Dirt-Bag-Lab-Supplies/SimpleBuck/README.md

# SimpleBuck
Simple buck-converter with selectable output voltage and current.
