Dirt-Bag-Lab-Supplies/SimpleBuck/pcb/lm2596_breakout/bom/lm2596_breakout_bom.ods

null | Sourced | Placed | References | Value | Footprint | description | mfg | mfg_pn | place | vendor | vendor_pn | Quantity
1 |  |  | C1 | RUBYCON_100ZLH100MEFC10X20 | CP_Radial_D10.0mm_P5.00mm | CAP ALUM 100UF 20% 100V RADIAL | Rubycon | 100ZLH100MEFC10X20 | YES | Digikey | 1189-1887-ND | 1
2 |  |  | C2 | PANASONIC_EEU-FC1H221B | CP_Radial_D10.0mm_P5.00mm | CAP ALUM 220UF 20% 50V RADIAL | Panasonic Electronic Components | EEU-FC1H221B | YES | Digikey | P19654CT-ND | 1
3 |  |  | R1 | STACKPOLE_CSRT2512FT50L0-UP | R_2512 | RES, CS, 2512, 0.05 OHM, 1%, 3.5W | Stackpole Electronics | CSRT2512FT50L0-UP | YES | Digikey | 738-CSRT2512FT50L0-UPTR-ND | 1
4 |  |  | R2 | VISHAYDALE_CRCW06031K20FKEAC | R_0603 | RES 1.2K OHM 1% 1/10W 0603 | Vishay Dale | CRCW06031K20FKEAC | YES | Digikey | 541-5225-2-ND | 1
5 |  |  | L1 | BOURNS_SRR1260A-330M | L_12x12mm_h8mm |  | Bourns Inc | SRR1260A-330M | YES | Digikey | SRR1260A-330MCT-ND | 1
6 |  |  | D1 | VISHAY_SSA34HE3_A_I | D_SMA |  | Vishay General Semiconductor | SSA34HE3_A/I | yes | Digikey | SSA34HE3_A/IGITR-ND | 1
7 |  |  | U1 | NATIONALSEMI_LM2596SX-ADJ | TO-263-5_TabPin6 | IC REG BUCK ADJ 3A TO263-5 | National Semiconductor | LM2596SX-ADJ | YES | Digikey | 2156-LM2596SX-ADJ-ND | 1
8 |  |  | RV1 | BOURNS_PV37W203C01B00 | Potentiometer_Trimmer_Bourns_3299Y | TRIMMER 20K OHM 0.25W PC PIN TOP | Bourns Inc | PV37W203C01B00 | yes | digikey | 490-2976-ND | 1
9 |  |  | J1, J2, J3, J4 | Conn_01x04 | Pin_Header_Straight_1x04_Pitch2.54mm |  |  |  |  |  |  | 4
