Dirt-Bag-Lab-Supplies/SimpleBuck/pcb/simpleBuck/simpleBuck.kicad_pcb

## KiCad design pcb/simpleBuck/simpleBuck.kicad_pcb (2022-04-18)

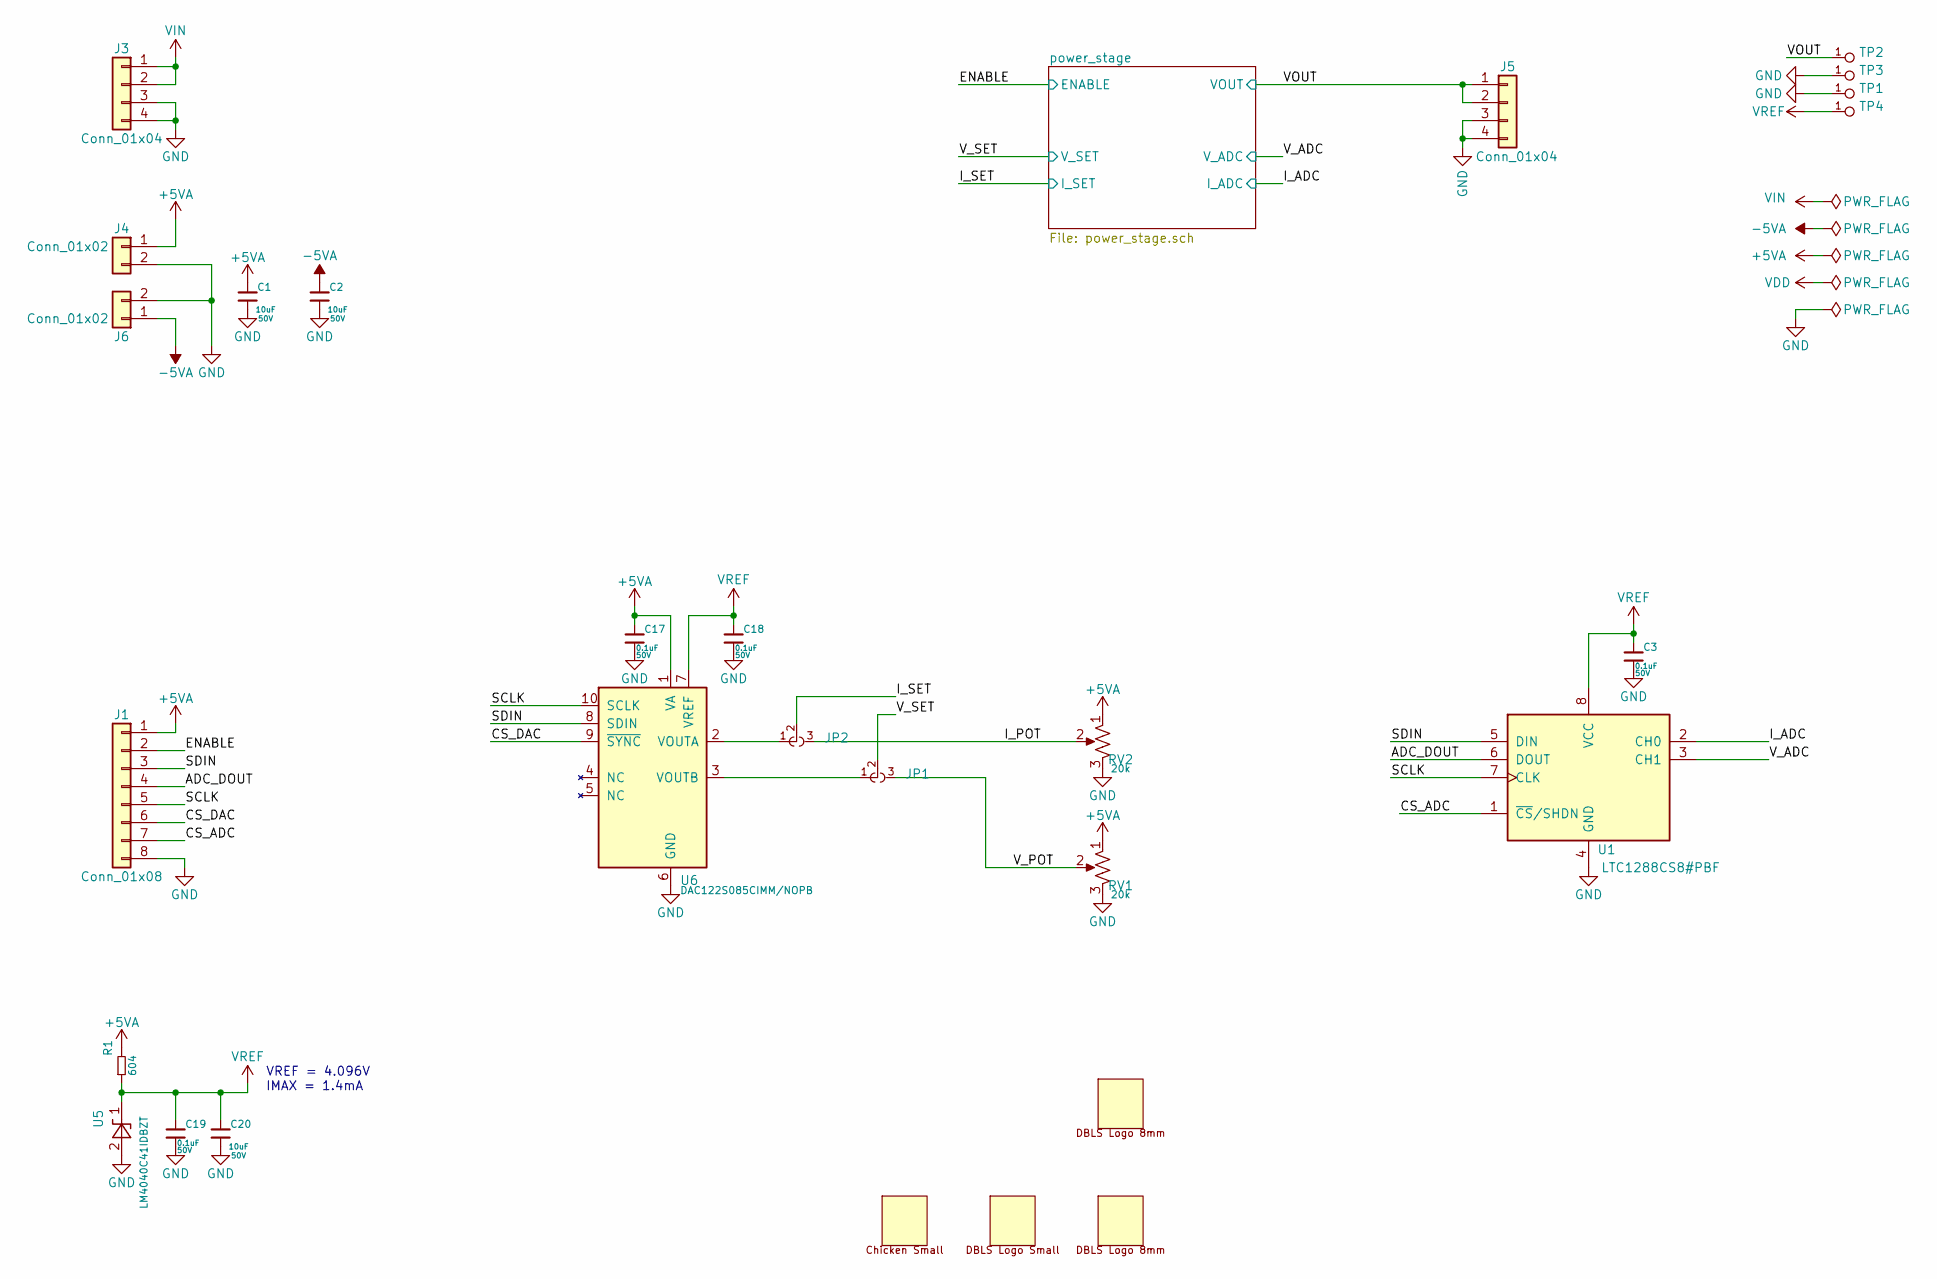
[picture p1: schematic simpleBuck.sch]

Parts:
C1, C2, C20: MURATA_GRT31CR61H106KE01L; C_1206; voltage 50V; mfg_pn GRT31CR61H106KE01L
C3, C17, C18, C19: MURATA_GCJ188R91H104KA01D; C_0603; voltage 50V; mfg_pn GCJ188R91H104KA01D
J1: Conn_01x08; Pin_Header_Straight_1x08_Pitch2.54mm
J3, J5: Conn_01x04; Pin_Header_Straight_1x04_Pitch2.54mm
J4, J6: Conn_01x02; Pin_Header_Straight_1x02_Pitch2.54mm
JP1, JP2: PAD_JUMPER_3PIN_12_NC_BY_TRACE
LOGO1: DBLS_Chicken_Small; Rooster_4mmx4mm
LOGO2: DBLS_van_logo_small_v1; van_logo_small
LOGO3: DBLS_van_logo_8mmX6mm; van_logo_8mmX6mm
LOGO4: DBLS_van_logo_8mmX6mm_mirror; van_logo_8mmX6mm_mirror
R1: VISHAYDALE_CRCW0603604RFKEAHP; R_0603; mfg_pn CRCW0603604RFKEAHP
RV1, RV2: BOURNS_PV37W203C01B00; Potentiometer_Trimmer_Bourns_3299Y; mfg_pn PV37W203C01B00
TP1, TP2, TP3, TP4: DBLS_TESTPOINT_NORMAL; DBLS_Testpoint_Normal
U1: ANALOG_LTC1288CS8#PBF; SOIC-8_3.9x4.9mm_Pitch1.27mm; mfg_pn LTC1288CS8#PBF
U5: TI_LM4040C41IDBZT; SOT-23; mfg_pn LM4040C41IDBZT
U6: TI_DAC122S085CIMM_NOPB; MSOP-10_3x3mm_Pitch0.5mm; mfg_pn DAC122S085CIMM/NOPB

Connections:
+5VA: C1.1, C17.1, J1.1, J4.1, R1.2, RV1.1, RV2.1, U6.1 (VA); also elsewhere on the board
-5VA: C2.1, J6.1; also elsewhere on the board
/ADC_DOUT: J1.4, U1.6 (DOUT)
/CS_ADC: J1.7, U1.1 (~CS~/SHDN)
/CS_DAC: J1.6, U6.9 (~SYNC)
/ENABLE: J1.2; also elsewhere on the board
/I_ADC: U1.2 (CH0); also elsewhere on the board
/I_POT: JP2.3, RV2.2
/I_SET: JP2.2; also elsewhere on the board
/SCLK: J1.5, U1.7 (CLK), U6.10 (SCLK)
/SDIN: J1.3, U1.5 (DIN), U6.8 (SDIN)
/VOUT: J5.1, J5.2, TP2.1; also elsewhere on the board
/V_ADC: U1.3 (CH1); also elsewhere on the board
/V_POT: JP1.3, RV1.2
/V_SET: JP1.2; also elsewhere on the board
GND: C1.2, C2.2, C3.2, C17.2, C18.2, C19.2, C20.2, J1.8, J3.3, J3.4, J4.2, J5.3, J5.4, J6.2, RV1.3, RV2.3, TP1.1, TP3.1, U1.4 (GND), U5.2 (A), U6.6 (GND); also elsewhere on the board
unnamed: JP1.1, U6.3 (VOUTB)
unnamed: JP2.1, U6.2 (VOUTA)
VIN: J3.1, J3.2; also elsewhere on the board
VREF: C3.1, C18.1, C19.1, C20.1, R1.1, TP4.1, U1.8 (VCC), U5.1 (K), U6.7 (VREF)

Notes on the sheet:
VREF = 4.096V IMAX = 1.4mA

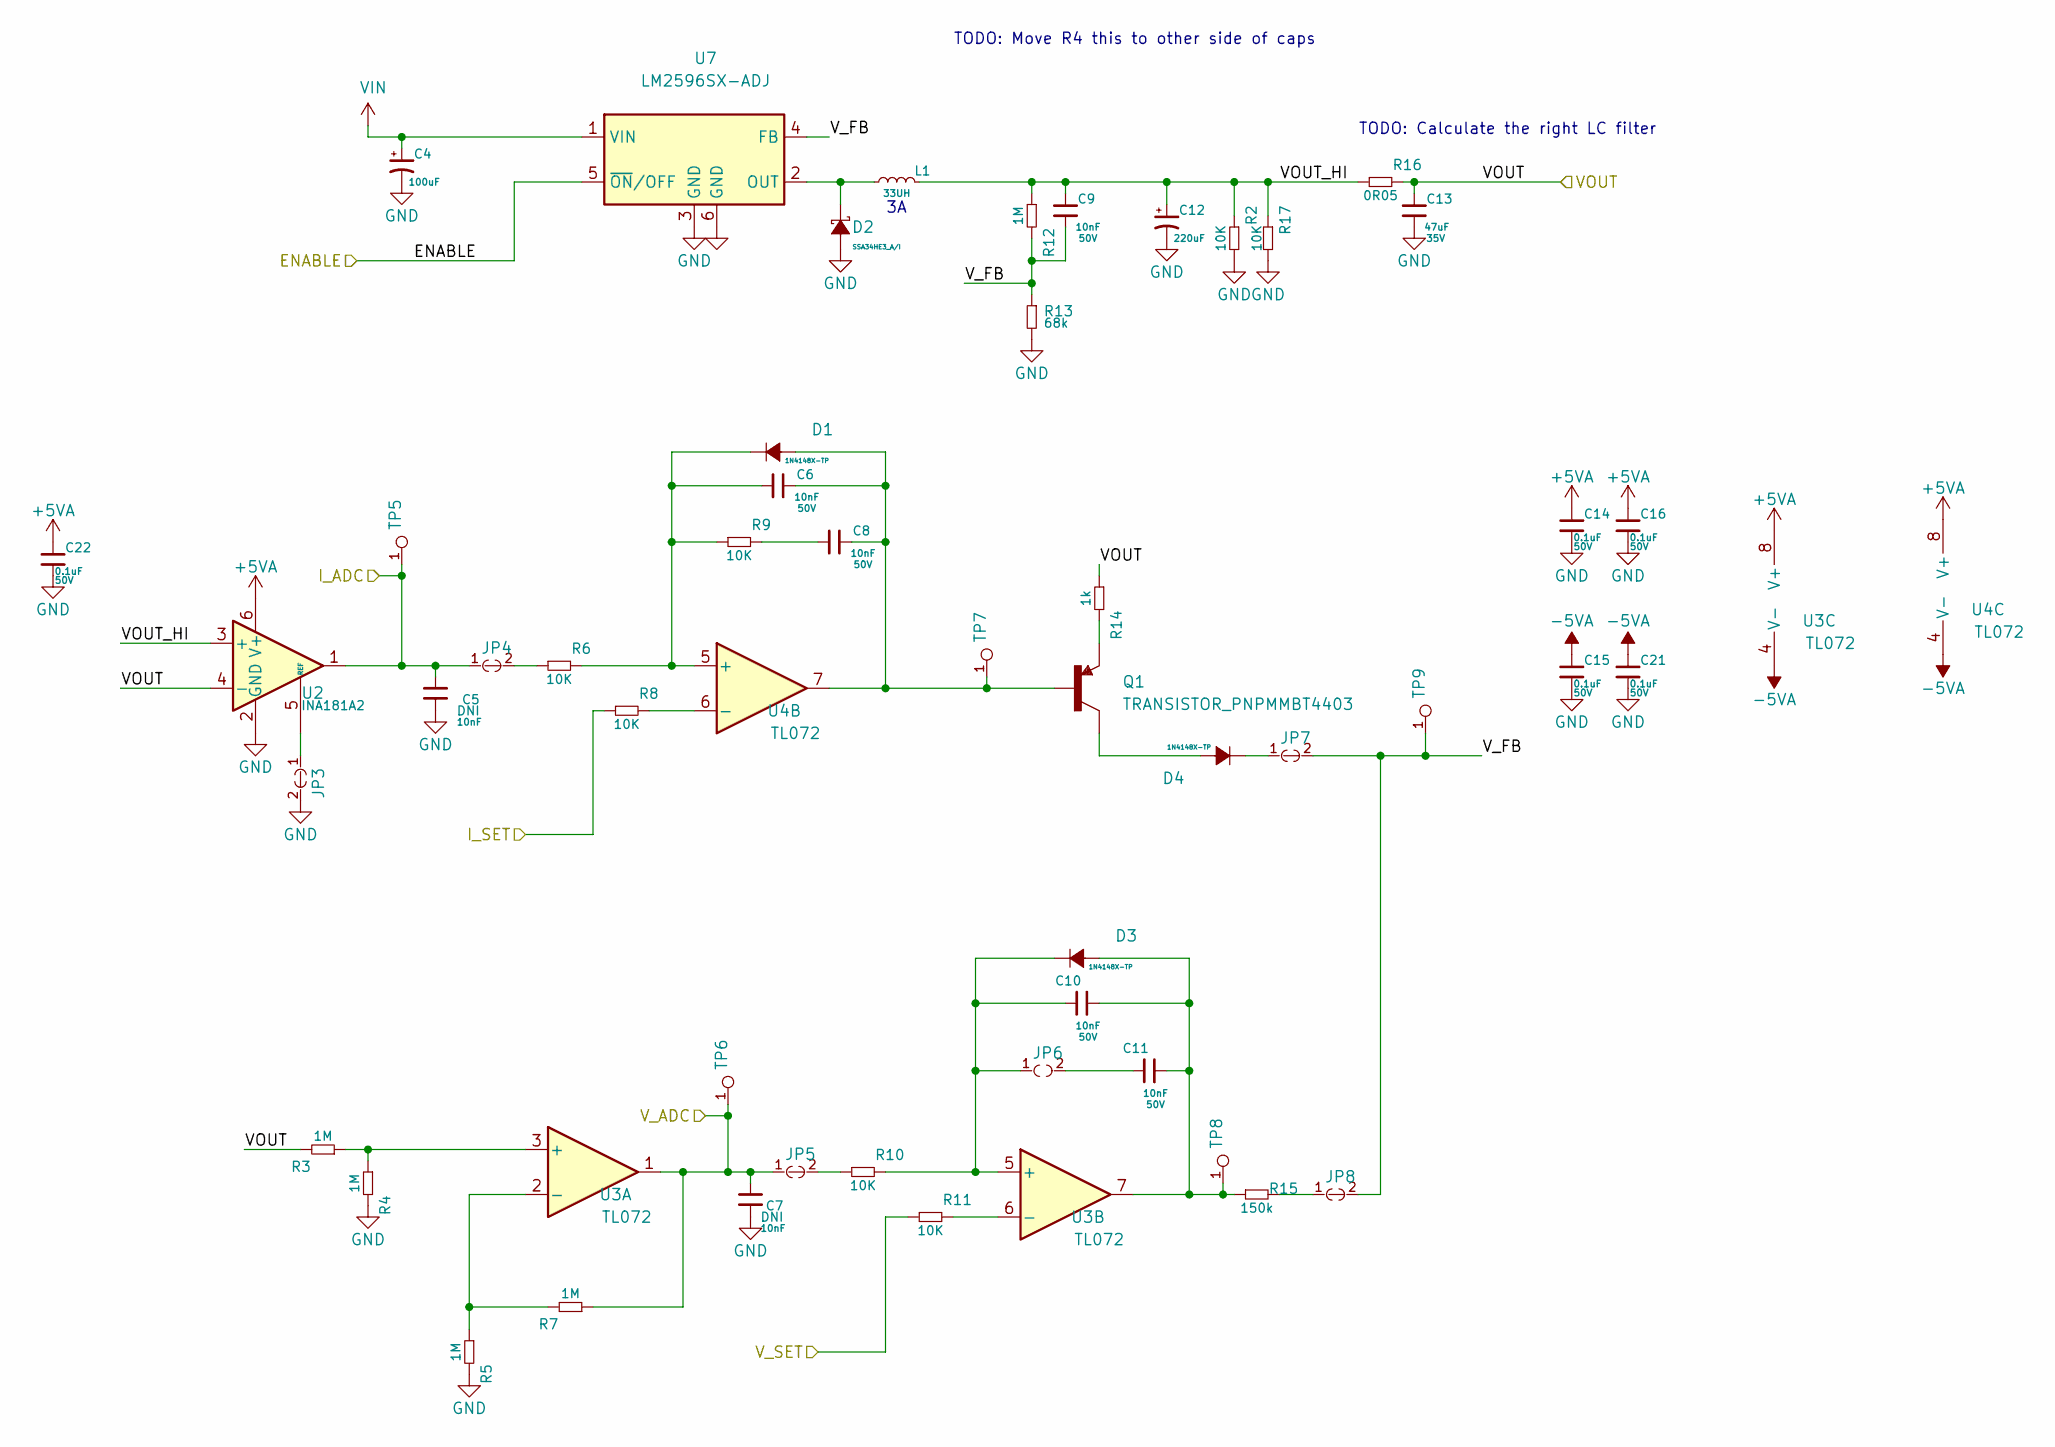
[picture p2: schematic power_stage.sch]

Parts:
C4: RUBYCON_100ZLH100MEFC10X20; CP_Radial_D10.0mm_P5.00mm; mfg_pn 100ZLH100MEFC10X20
C5, C6, C7, C8, C9, C10, C11: KEMET_C0603C103K5RAL7867; C_0603; voltage 50V; mfg_pn C0603C103K5RAL7867
C12: PANASONIC_EEU-FC1H221B; CP_Radial_D10.0mm_P5.00mm; mfg_pn EEU-FC1H221B
C13: MURATA_KRM55WR7YA476MH01L; C_2220; voltage 35V; mfg_pn KRM55WR7YA476MH01L
C14, C15, C16, C21, C22: MURATA_GCJ188R91H104KA01D; C_0603; voltage 50V; mfg_pn GCJ188R91H104KA01D
D1, D3, D4: MICRO_COMMERCIAL_1N4148X-TP; LED_0603; mfg_pn 1N4148X-TP
D2: VISHAY_SSA34HE3_A_I; D_SMA; mfg_pn SSA34HE3_A/I
JP3, JP4, JP5, JP7, JP8: PAD_JUMPER_2PIN_NC_BY_TRACE
JP6: PAD_JUMPER_2PIN_NO; PAD_JUMPER_2PIN_NO_0603
L1: BOURNS_SRR1260A-330M; L_12x12mm_h8mm; mfg_pn SRR1260A-330M
Q1: TRANSISTOR_PNPMMBT4403; SOT-23
R2, R6, R8, R9, R10, R11, R17: VISHAY_CRCW060310K0FKEBC; R_0603; mfg_pn CRCW060310K0FKEBC
R3, R4, R5, R7, R12: VISHAYDALE_CRCW06031M00FKEAC; R_0603; mfg_pn CRCW06031M00FKEAC
R13: VISHAYDALE_CRCW060368K0FKEA; R_0603; mfg_pn CRCW060368K0FKEA
R14: SMD-RES-1.0K-0603; R_0603; mfg_pn ESR03EZPF1001
R15: VISHAYDALE_CRCW0603150KFKEAC; R_0603; mfg_pn CRCW0603150KFKEAC
R16: STACKPOLE_CSRT2512FT50L0-UP; R_2512; mfg_pn CSRT2512FT50L0-UP
TP5, TP6, TP7, TP8, TP9: DBLS_TESTPOINT_NORMAL; DBLS_Testpoint_Normal
U2: TI_INA181A2; SOT-23-6; mfg_pn INA181A2IDBVT
U3, U4: TI_TL072HIDBVR; SOIC-8_3.9x4.9mm_Pitch1.27mm; mfg_pn TL072HIDBVR
U7: NATIONALSEMI_LM2596SX-ADJ; TO-263-5_TabPin6; mfg_pn LM2596SX-ADJ

Connections:
+5VA: C14.1, C16.1, C22.1, U2.6 (V+), U3.8 (V+), U4.8 (V+); also elsewhere on the board
-5VA: C15.1, C21.1, U3.4 (V-), U4.4 (V-); also elsewhere on the board
/ENABLE: U7.5 (~ON~/OFF); also elsewhere on the board
/I_ADC: C5.2, JP4.1, TP5.1, U2.1; also elsewhere on the board
/I_SET: R8.1; also elsewhere on the board
/VOUT: C13.1, R3.2, R14.1, R16.2, U2.4 (-); also elsewhere on the board
/V_ADC: C7.2, JP5.1, R7.1, TP6.1, U3.1; also elsewhere on the board
/V_SET: R11.1; also elsewhere on the board
/power_stage/VOUT_HI: C9.1, C12.1, L1.2, R2.1, R12.1, R16.1, R17.1, U2.3 (+)
/power_stage/V_FB: C9.2, JP7.2, JP8.2, R12.2, R13.1, TP9.1, U7.4 (FB)
GND: C4.2, C5.1, C7.1, C12.2, C13.2, C14.2, C15.2, C16.2, C21.2, C22.2, D2.2 (A), JP3.2, R2.2, R4.2, R5.2, R13.2, R17.2, U2.2 (GND), U7.3 (GND), U7.6 (GND); also elsewhere on the board
unnamed: C6.1, C8.1, D1.2 (A), Q1.1 (B), TP7.1, U4.7
unnamed: C6.2, D1.1 (K), R6.2, R9.1, U4.5 (+)
unnamed: C8.2, R9.2
unnamed: C10.1, C11.1, D3.2 (A), R15.1, TP8.1, U3.7
unnamed: C10.2, D3.1 (K), JP6.1, R10.2, U3.5 (+)
unnamed: C11.2, JP6.2
unnamed: D2.1 (K), L1.1, U7.2 (OUT)
unnamed: D4.1 (K), JP7.1
unnamed: D4.2 (A), Q1.3 (C)
unnamed: JP3.1, U2.5 (REF)
unnamed: JP4.2, R6.1
unnamed: JP5.2, R10.1
unnamed: JP8.1, R15.2
unnamed: Q1.2 (E), R14.2
unnamed: R3.1, R4.1, U3.3 (+)
unnamed: R5.1, R7.2, U3.2 (-)
unnamed: R8.2, U4.6 (-)
unnamed: R11.2, U3.6 (-)
VIN: C4.1, U7.1 (VIN); also elsewhere on the board

Notes on the sheet:
TODO: Calculate the right LC filter
TODO: Move R4 this to other side of caps

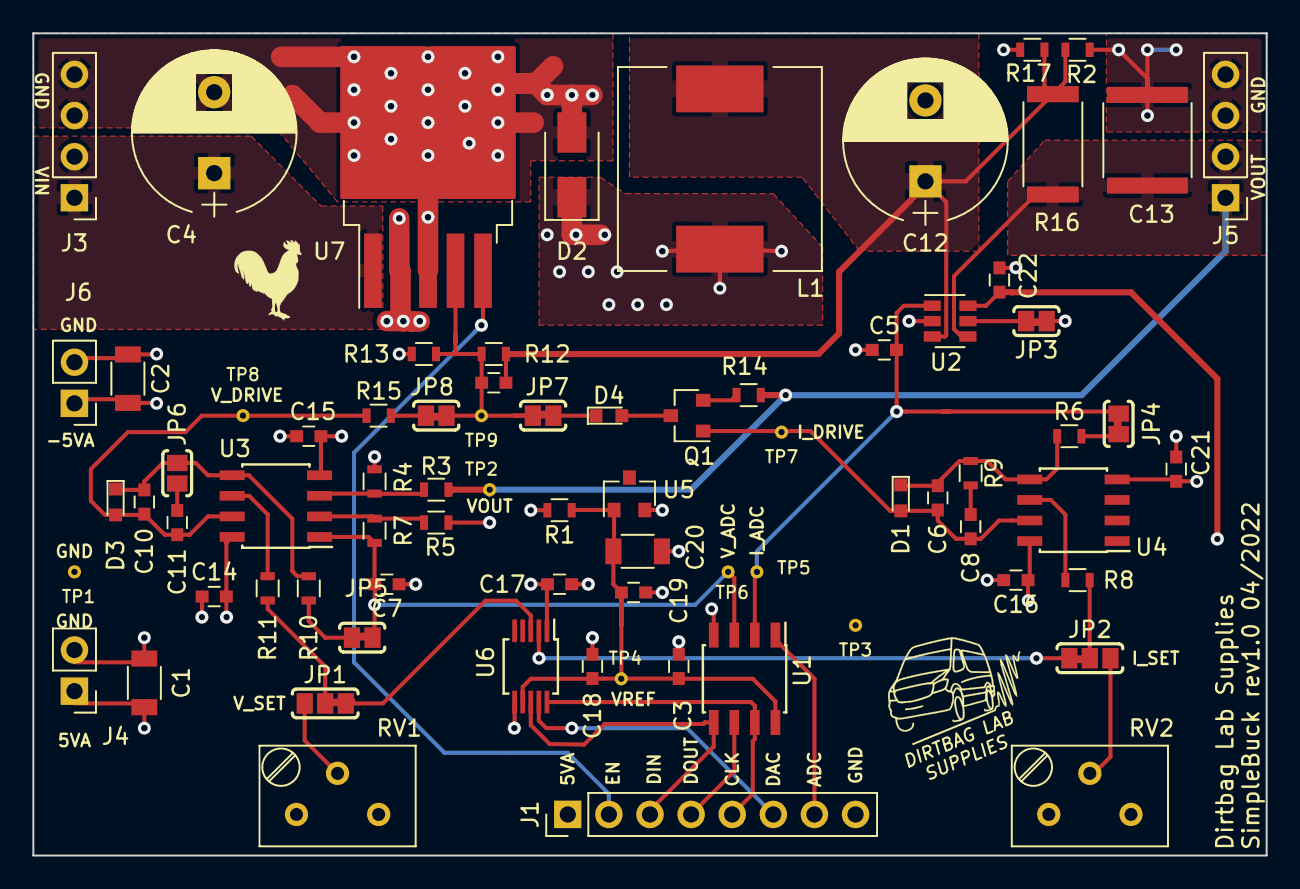
[picture p3: board simpleBuck.kicad_pcb from above]

Board: 4 copper layers, 76.2 x 50.8 mm, 79 parts (1 on the bottom side), 40 nets.
