Dirt-Bag-Lab-Supplies/SimpleBuck/pcb/lm2596_breakout/lm2596_breakout.kicad_pcb

## KiCad design pcb/lm2596_breakout/lm2596_breakout.kicad_pcb (2022-02-16)

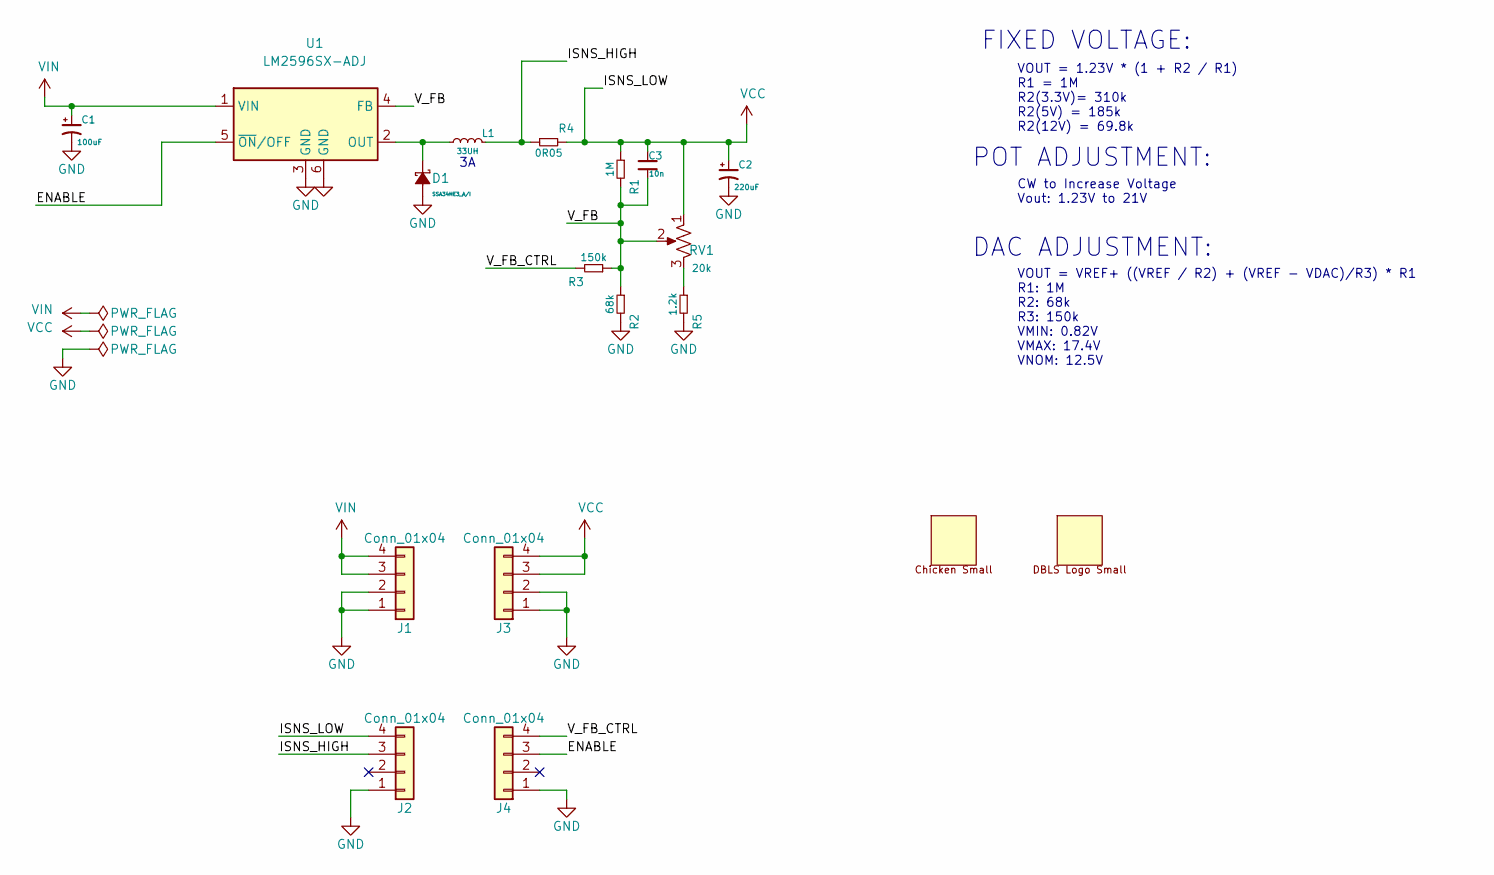
[picture p4: schematic lm2596_breakout.sch]

Parts:
C1: RUBYCON_100ZLH100MEFC10X20; CP_Radial_D10.0mm_P5.00mm; mfg_pn 100ZLH100MEFC10X20
C2: PANASONIC_EEU-FC1H221B; CP_Radial_D10.0mm_P5.00mm; mfg_pn EEU-FC1H221B
C3: MURATA_GCM155R71E103KA37D; C_0402; mfg_pn GCM155R71E103KA37D
D1: VISHAY_SSA34HE3_A_I; D_SMA; mfg_pn SSA34HE3_A/I
J1, J2, J3, J4: Conn_01x04; Pin_Header_Straight_1x04_Pitch2.54mm
L1: BOURNS_SRR1260A-330M; L_12x12mm_h8mm; mfg_pn SRR1260A-330M
LOGO1: DBLS_Chicken_Small; Rooster_4mmx4mm
LOGO2: DBLS_van_logo_small_v1; van_logo_small
R1: VISHAYDALE_CRCW04021M00FKEDC; R_0402; mfg_pn CRCW04021M00FKEDC
R2: VISHAYDALE_CRCW040268K0FKEDC; R_0402; mfg_pn CRCW040268K0FKEDC
R3: VISHAYDALE_CRCW0402150KFKEDC; R_0402; mfg_pn CRCW0402150KFKEDC
R4: STACKPOLE_CSRT2512FT50L0-UP; R_2512; mfg_pn CSRT2512FT50L0-UP
R5: VISHAYDALE_CRCW06031K20FKEAC; R_0603; mfg_pn CRCW06031K20FKEAC
RV1: BOURNS_PV37W203C01B00; Potentiometer_Trimmer_Bourns_3299Y; mfg_pn PV37W203C01B00
U1: NATIONALSEMI_LM2596SX-ADJ; TO-263-5_TabPin6; mfg_pn LM2596SX-ADJ

Connections:
/ENABLE: J4.3, U1.5 (~ON~/OFF)
/ISNS_HIGH: J2.3, L1.2, R4.1
/V_FB: C3.2, R1.2, R2.1, R3.1, RV1.2, U1.4 (FB)
/V_FB_CTRL: J4.4, R3.2
GND: C1.2, C2.2, D1.2 (A), J1.1, J1.2, J2.1, J3.1, J3.2, J4.1, R2.2, R5.2, U1.3 (GND), U1.6 (GND)
unnamed: D1.1 (K), L1.1, U1.2 (OUT)
unnamed: R5.1, RV1.3
VCC: C2.1, C3.1, J2.4, J3.3, J3.4, R1.1, R4.2, RV1.1
VIN: C1.1, J1.3, J1.4, U1.1 (VIN)

Notes on the sheet:
VOUT = 1.23V * (1 + R2 / R1) R1 = 1M R2(3.3V)= 310k R2(5V) = 185k R2(12V) = 69.8k
CW to Increase Voltage Vout: 1.23V to 21V
FIXED VOLTAGE:
POT ADJUSTMENT:
DAC ADJUSTMENT:
VOUT = VREF+ ((VREF / R2) + (VREF - VDAC)/R3) * R1 R1: 1M R2: 68k R3: 150k VMIN: 0.82V VMAX: 17.4V VNOM: 12.5V

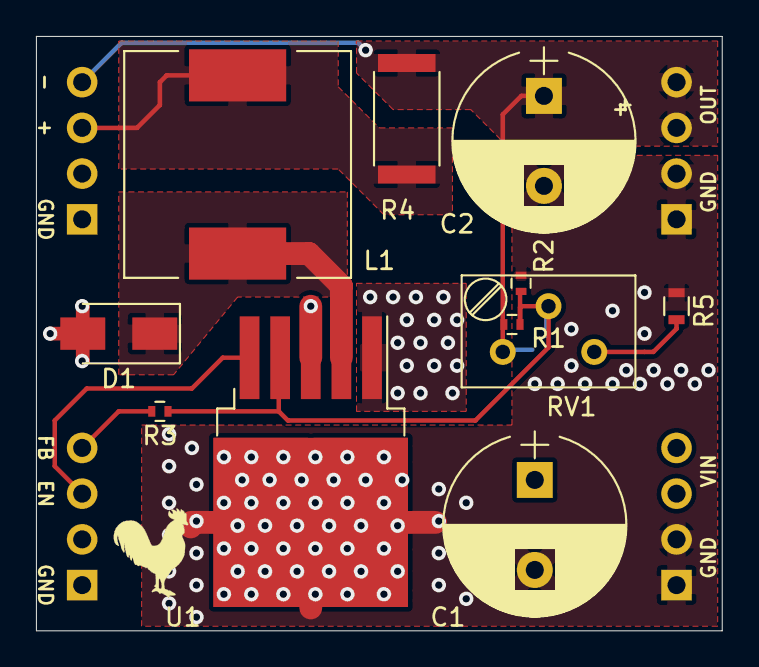
[picture p5: board lm2596_breakout.kicad_pcb from above]

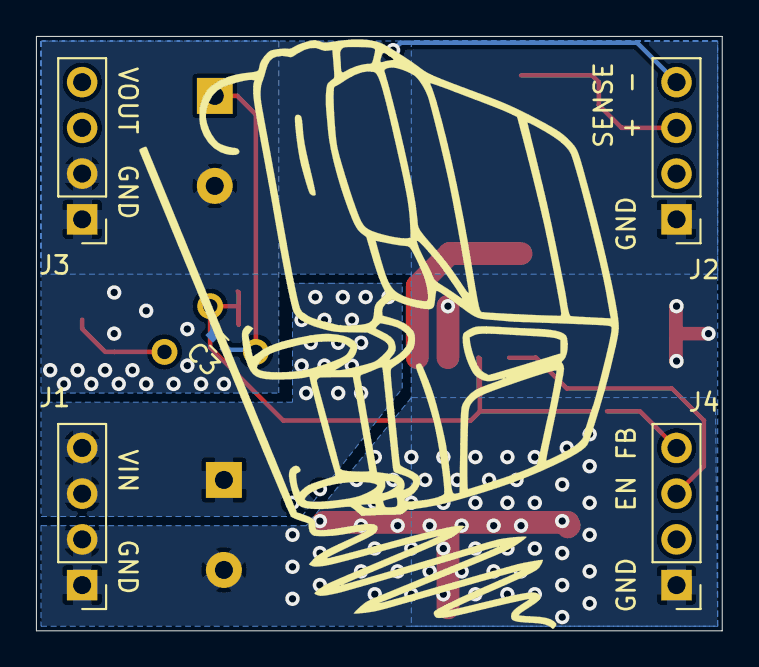
[picture p6: board lm2596_breakout.kicad_pcb from below]

Board: 2 copper layers, 38.1 x 33.0 mm, 18 parts (6 on the bottom side), 9 nets.
