Dirt-Bag-Lab-Supplies/SimpleBuck/(commit log)

2020-11-01 Schematic draft
    [simpleBuck.kicad_pcb, simpleBuck.sch]
2022-02-01 Made lm2596 breakout board.
    [lm2596_breakout.kicad_pcb, lm2596_breakout.sch, simpleBuck.sch]
2022-02-07 Rough layout + silkscreen.
    [lm2596_breakout.kicad_pcb, lm2596_breakout.sch]
2022-02-08 layout + bom completed.
    [lm2596_breakout-B_Cu.gbr, lm2596_breakout-B_Mask.gbr, lm2596_breakout-B_Paste.gbr, lm2596_breakout-B_SilkS.gbr, lm2596_breakout-Edge_Cuts.gbr, lm2596_breakout-F_Cu.gbr, lm2596_breakout-F_Mask.gbr, lm2596_breakout-F_Paste.gbr]
2022-02-16 v1 - placed order with OSH park
    [lm2596_breakout-B_Cu.gbr, lm2596_breakout-B_Mask.gbr, lm2596_breakout-B_Paste.gbr, lm2596_breakout-B_SilkS.gbr, lm2596_breakout-Edge_Cuts.gbr, lm2596_breakout-F_Cu.gbr, lm2596_breakout-F_Mask.gbr, lm2596_breakout-F_Paste.gbr]
2022-04-14 Added lm2596 and DACS + prelim layout.
    [lm2596_breakout.sch, simpleBuck.kicad_pcb, simpleBuck.sch]
2022-04-16 Updated schematic to include lm2596 on board.
    [lm2596_breakout.sch, power_stage.sch, simpleBuck.kicad_pcb, simpleBuck.sch]
2022-04-17 Added jumpers and finalized DAC/ADC selection.
    [power_stage.sch, simpleBuck.kicad_pcb, simpleBuck.sch]
2022-04-17 Prelim Layout before silkscreen tuning.
    [power_stage.sch, simpleBuck.kicad_pcb, simpleBuck.sch]
2022-04-17 Finished layout. Heading to fab
    [simpleBuck.kicad_pcb, simpleBuck.sch]
2022-04-18 Minor movement of text
    [simpleBuck.kicad_pcb]
